jp0808200/doser/HardWare/3d models/kansi.3mf

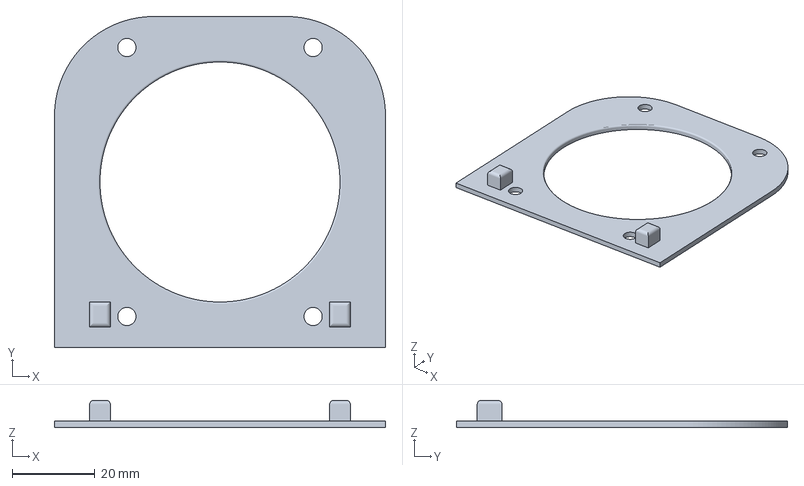
[picture p1: CAD file, 2026-10-14]
HardWare/3d models/kansi.3mf
80.0 x 80.0 x 6.60 mm
