jp0808200/doser/HardWare/3d models/pohja.3mf

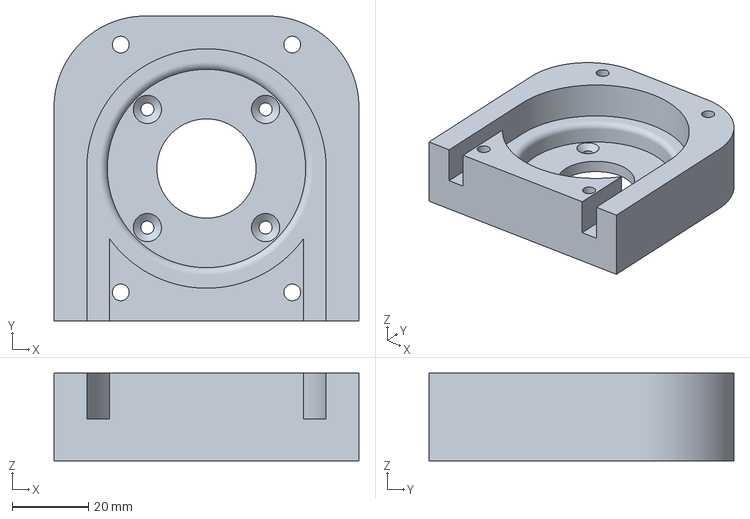
[picture p2: CAD file, 2026-10-14]
HardWare/3d models/pohja.3mf
80.0 x 80.0 x 23.0 mm
