jp0808200/doser/HardWare/3d models/spacer17.amf

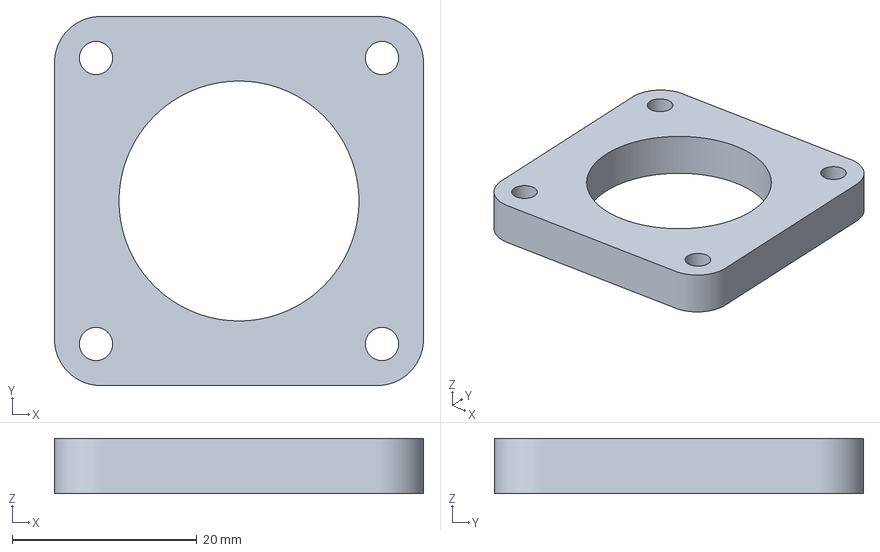
[picture p3: CAD file, 2026-10-14]
HardWare/3d models/spacer17.amf
40.0 x 40.0 x 6.00 mm
