jp0808200/doser/HardWare/Doser_v1_schema.pdf

# FLT 10 2A 11 1A 12 1B 13 2B 14 GND 15 VMOT 16

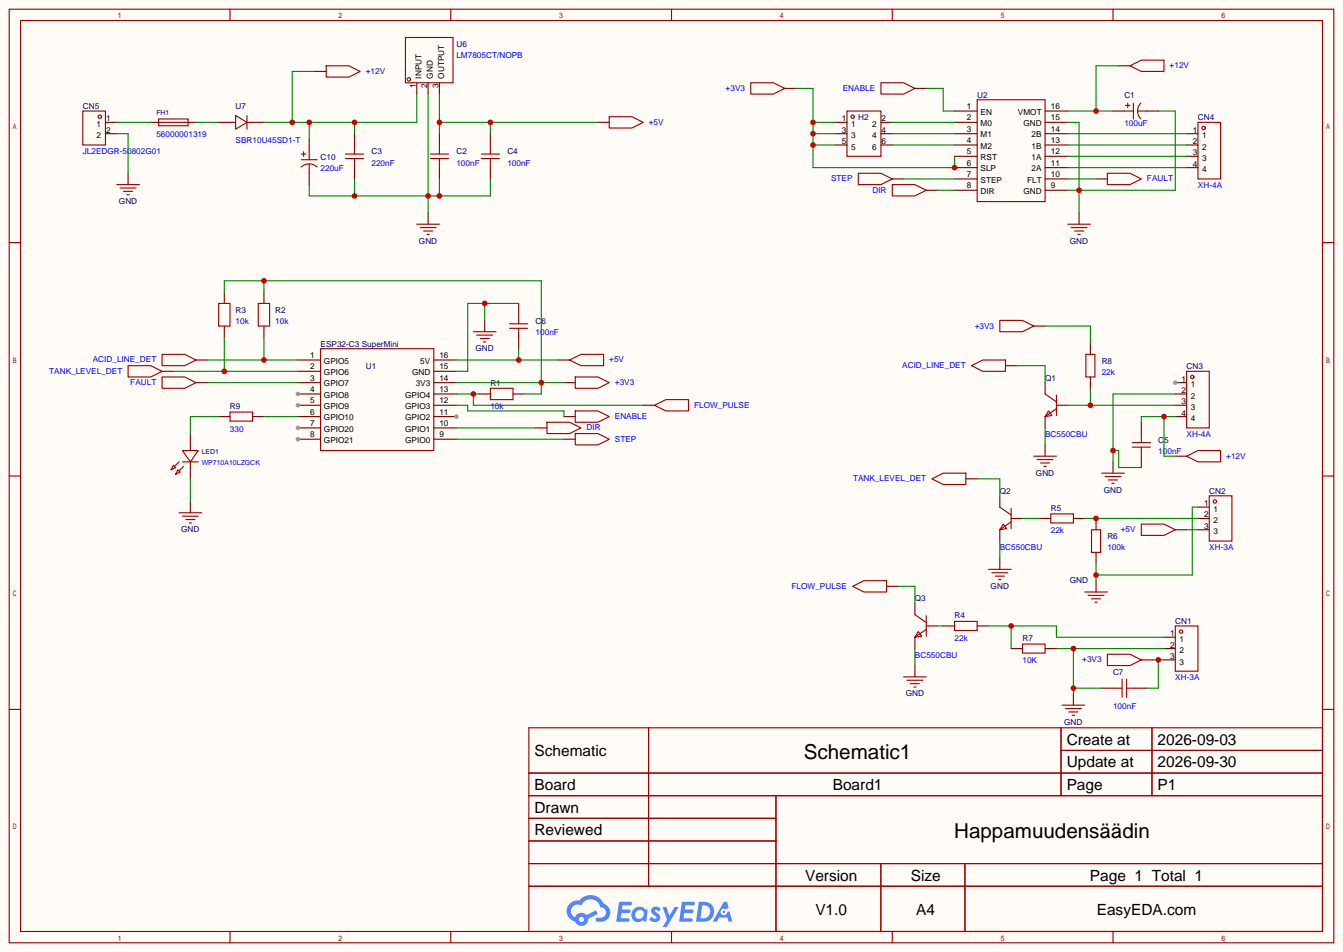
[picture p4: page 1]

Schematic | Schematic1 | Create at | 2026-09-03

Update at | 2026-09-30

Board | Board1 | Page | P1
Drawn | | Happamuudensäädin
Reviewed

Version | Size | Page 1 Total 1
V1.0 | A4 | EasyEDA.com
