jp0808200/doser/HardWare/Laakeriakseli.pdf

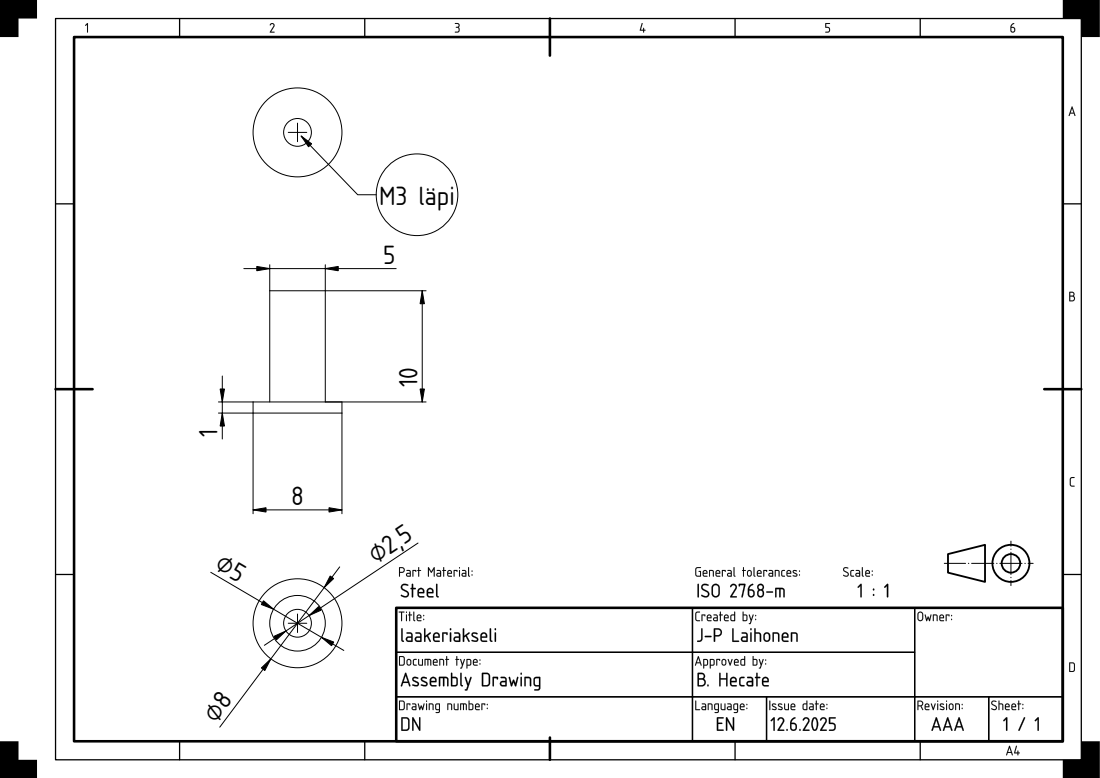
[picture p5: page 1]
M3 läpi
