jp0808200/doser/HardWare/motormount.pdf

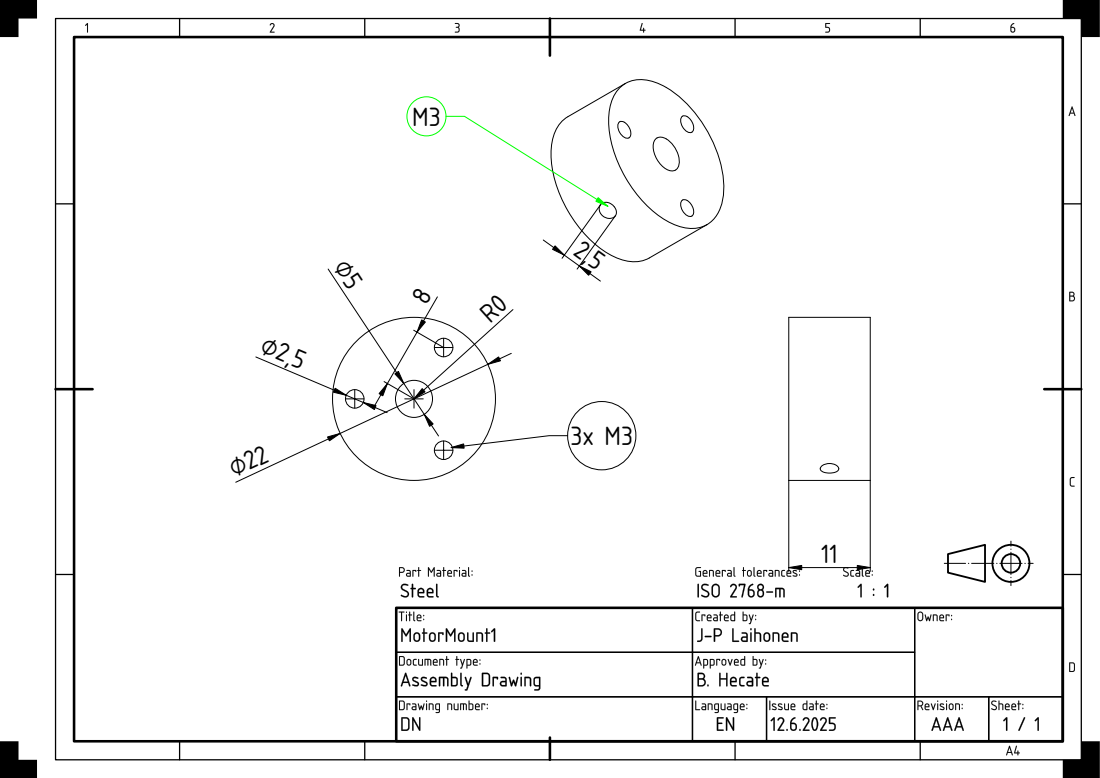
[picture p6: page 1]
