jp0808200/doser/HardWare/pumppulevy.pdf

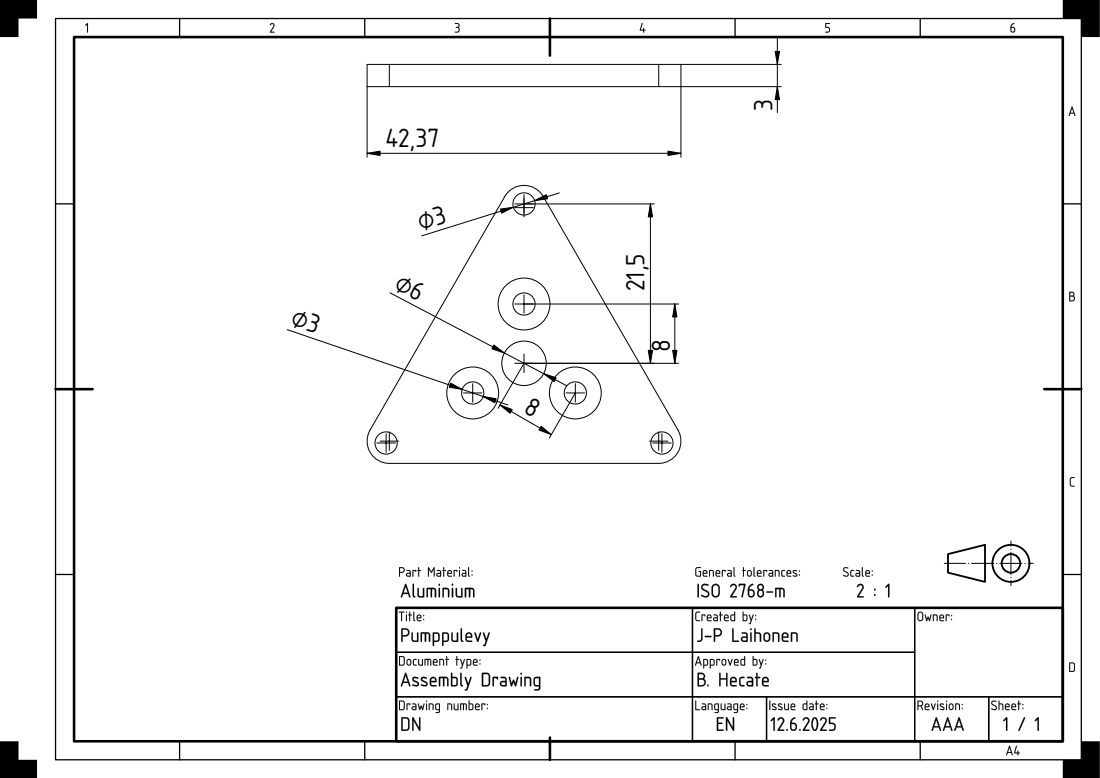
[picture p7: page 1]
